apmm-25/trator_gps/ESP32_PWR_Computation_hardware/default_esp32_board/board_step/default_esp32_board.step

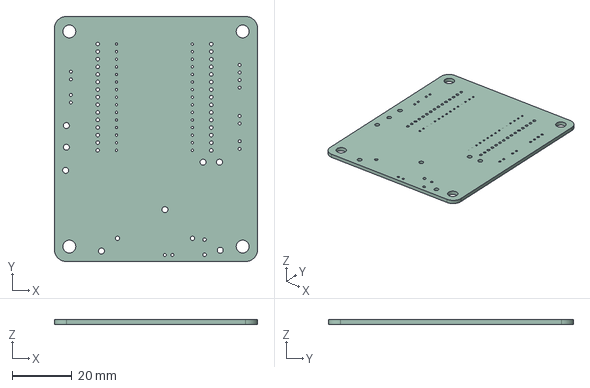
[picture p1: CAD file, 2026-06-18, last stored version]
ESP32_PWR_Computation_hardware/default_esp32_board/board_step/default_esp32_board.step
68.0 x 82.0 x 1.51 mm
