apmm-25/trator_gps/ESP32_PWR_Computation_hardware/default_esp32_board/componentes_zips/LIB_AP63203WU-7/AP63203WU-7/3D/AP63203WU-7.stp

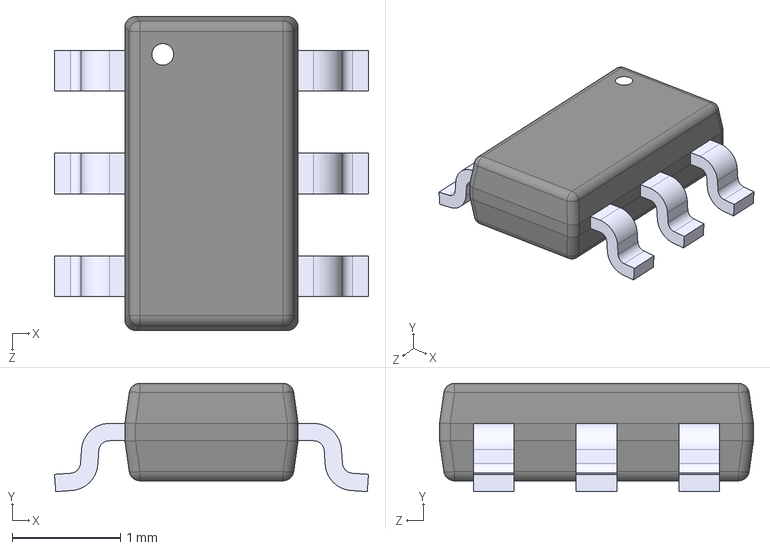
[picture p2: CAD file, 2026-06-18, last stored version]
ESP32_PWR_Computation_hardware/default_esp32_board/componentes_zips/LIB_AP63203WU-7/AP63203WU-7/3D/AP63203WU-7.stp
2.90 x 1.00 x 2.90 mm
