apmm-25/trator_gps/ESP32_PWR_Computation_hardware/default_esp32_board/componentes_zips/LIB_TPS56339DDCR/TPS56339DDCR/3D/TPS56339DDCR.stp

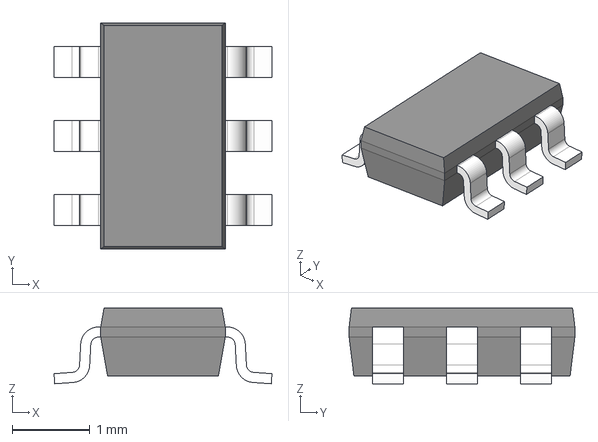
[picture p3: CAD file, 2026-06-18, last stored version]
ESP32_PWR_Computation_hardware/default_esp32_board/componentes_zips/LIB_TPS56339DDCR/TPS56339DDCR/3D/TPS56339DDCR.stp
2.80 x 2.90 x 0.97 mm
BODY-SOT
LEAD-SOT x 6
