apmm-25/trator_gps/(list of files, cad)

Other CAD files:
ESP32_PWR_Computation_hardware/default_esp32_board/componentes_zips/LIB_AP63203WU-7/AP63203WU-7/Allegro/ap63203wu7.psm
ESP32_PWR_Computation_hardware/default_esp32_board/componentes_zips/LIB_AP63203WU-7/AP63203WU-7/DEHDL/ap63203wu_7/chips/chips.prt
ESP32_PWR_Computation_hardware/default_esp32_board/componentes_zips/LIB_TPS56339DDCR/TPS56339DDCR/Allegro/sot95p280x110-6n.psm
ESP32_PWR_Computation_hardware/default_esp32_board/componentes_zips/LIB_TPS56339DDCR/TPS56339DDCR/DEHDL/tps56339ddcr/chips/chips.prt
