apmm-25/trator_gps/(list of files, drawings)

Other design files:
ESP32_PWR_Computation_hardware/default_esp32_board/componentes_zips/LIB_AP63203WU-7/AP63203WU-7/Altium/AP63203WU7.PcbLib
ESP32_PWR_Computation_hardware/default_esp32_board/componentes_zips/LIB_AP63203WU-7/AP63203WU-7/Altium/AP63203WU-7.SchLib
ESP32_PWR_Computation_hardware/default_esp32_board/componentes_zips/LIB_TPS56339DDCR/TPS56339DDCR/Altium/SOT95P280X110-6N.PcbLib
ESP32_PWR_Computation_hardware/default_esp32_board/componentes_zips/LIB_TPS56339DDCR/TPS56339DDCR/Altium/TPS56339DDCR.SchLib
