apmm-25/trator_gps/ESP32_PWR_Computation_hardware/default_esp32_board/default_esp32_board.kicad_pcb

## KiCad design ESP32_PWR_Computation_hardware/default_esp32_board/default_esp32_board.kicad_pcb (2026-06-18, last stored version)

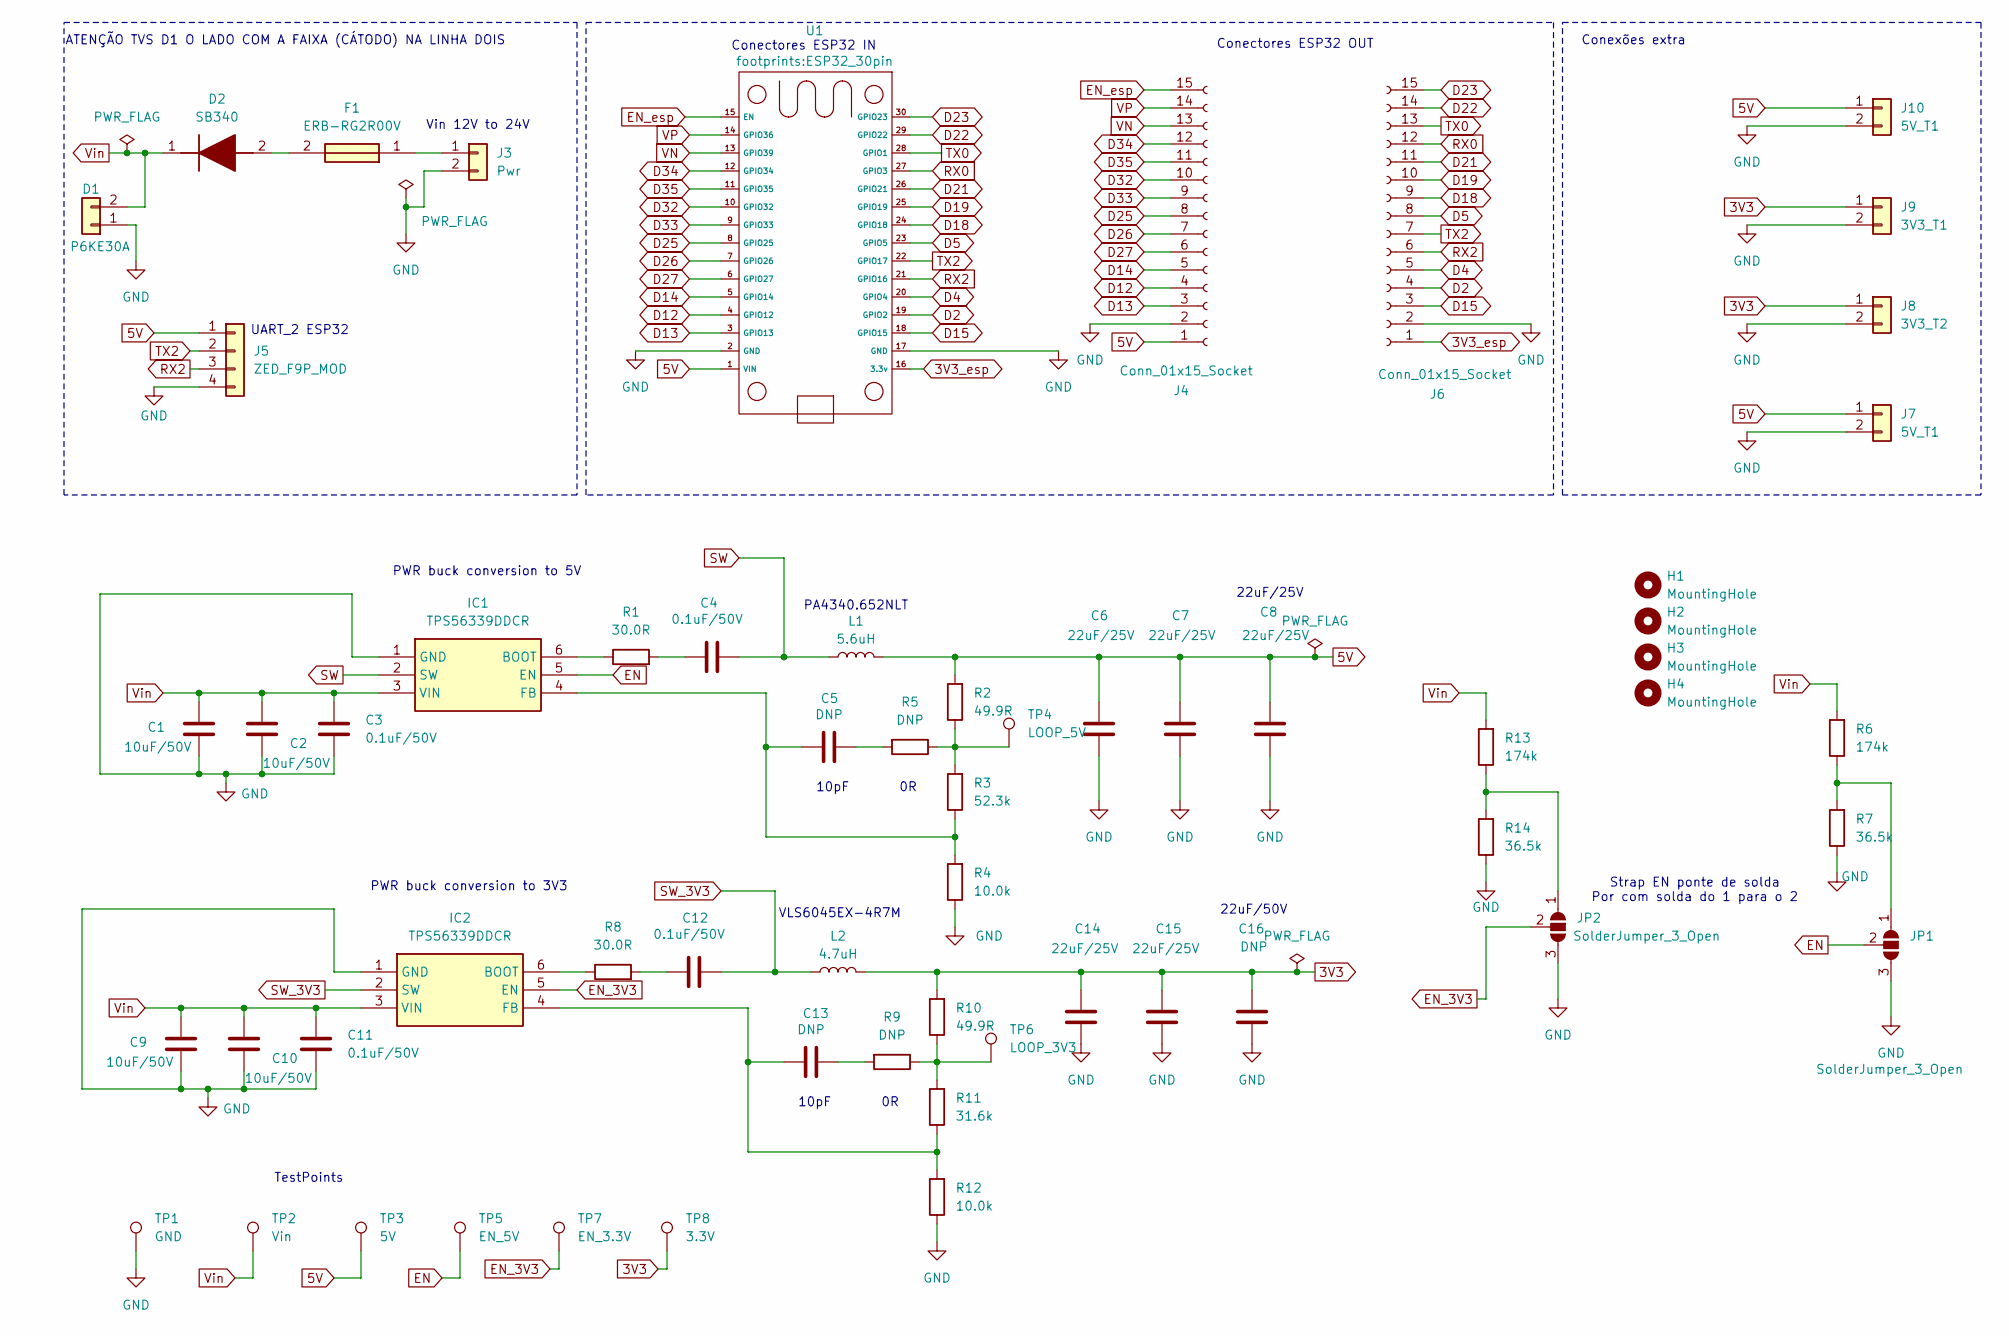
[picture p4: schematic default_esp32_board.kicad_sch]

Parts:
C1, C2, C9, C10: 10uF/50V; C_0805_2012Metric_Pad1.18x1.45mm_HandSolder
C3, C4, C11, C12: 0.1uF/50V; C_0805_2012Metric_Pad1.18x1.45mm_HandSolder
C5, C13, C16: DNP; C_0805_2012Metric_Pad1.18x1.45mm_HandSolder
C6, C7, C8, C14, C15: 22uF/25V; C_0805_2012Metric_Pad1.18x1.45mm_HandSolder
D1: P6KE30A; D_DO-15_P5.08mm_Vertical_KathodeUp
D2: SB340; Mouser Part Number 637-SB340
F1: ERB-RG2R00V; ERBRG4R00V; Mouser Part Number 667-ERB-RG2R00V
H1, H2, H3, H4: MountingHole; MountingHole_4.3mm_M4
IC1, IC2: TPS56339DDCR; Mouser Part Number 595-TPS56339DDCR
J3: Pwr; PinHeader_1x02_P2.54mm_Vertical
J4, J6: Conn_01x15_Socket; M20-7821546
J5: ZED_F9P_MOD; PinHeader_1x04_P2.54mm_Vertical
J7, J10: 5V_T1; PinHeader_1x02_P2.54mm_Vertical
J8: 3V3_T2; PinHeader_1x02_P2.54mm_Vertical
J9: 3V3_T1; PinHeader_1x02_P2.54mm_Vertical
JP1, JP2: SolderJumper_3_Open; SolderJumper-3_P1.3mm_Open_Pad1.0x1.5mm_NumberLabels
L1: 5.6uH; PA4340562NLT
L2: 4.7uH; VLS6045
R1, R8: 30.0R; R_0805_2012Metric_Pad1.20x1.40mm_HandSolder
R2, R10: 49.9R; R_0805_2012Metric_Pad1.20x1.40mm_HandSolder
R3: 52.3k; R_0805_2012Metric_Pad1.20x1.40mm_HandSolder
R4, R12: 10.0k; R_0805_2012Metric_Pad1.20x1.40mm_HandSolder
R5, R9: DNP; R_0805_2012Metric_Pad1.20x1.40mm_HandSolder
R6, R13: 174k; R_0805_2012Metric_Pad1.20x1.40mm_HandSolder
R7, R14: 36.5k; R_0805_2012Metric_Pad1.20x1.40mm_HandSolder
R11: 31.6k; R_0805_2012Metric_Pad1.20x1.40mm_HandSolder
TP1: GND; TestPoint_Plated_Hole_D2.0mm
TP2: Vin; TestPoint_Plated_Hole_D2.0mm
TP3: 5V; TestPoint_Plated_Hole_D2.0mm
TP4: LOOP_5V; TestPoint_Plated_Hole_D2.0mm
TP5: EN_5V; TestPoint_Plated_Hole_D2.0mm
TP6: LOOP_3V3; TestPoint_Plated_Hole_D2.0mm
TP7: EN_3.3V; TestPoint_Plated_Hole_D2.0mm
TP8: 3.3V; TestPoint_Plated_Hole_D2.0mm
U1: ESP32_30pin

Connections:
3V3: C14.1, C15.1, C16.1, J8.1, J9.1, L2.2, R10.2, TP8.1
3V3_esp: J6.1, U1.16 (3.3v)
5V: C6.1, C7.1, C8.1, J4.1, J5.1, J7.1, J10.1, L1.2, R2.2, TP3.1, U1.1 (VIN)
D2: J6.4, U1.19 (GPIO2)
D4: J6.5, U1.20 (GPIO4)
D5: J6.8, U1.23 (GPIO5)
D12: J4.4, U1.4 (GPIO12)
D13: J4.3, U1.3 (GPIO13)
D14: J4.5, U1.5 (GPIO14)
D15: J6.3, U1.18 (GPIO15)
D18: J6.9, U1.24 (GPIO18)
D19: J6.10, U1.25 (GPIO19)
D21: J6.11, U1.26 (GPIO21)
D22: J6.14, U1.29 (GPIO22)
D23: J6.15, U1.30 (GPIO23)
D25: J4.8, U1.8 (GPIO25)
D26: J4.7, U1.7 (GPIO26)
D27: J4.6, U1.6 (GPIO27)
D32: J4.10, U1.10 (GPIO32)
D33: J4.9, U1.9 (GPIO33)
D34: J4.12, U1.12 (GPIO34)
D35: J4.11, U1.11 (GPIO35)
EN: IC1.5 (EN), JP1.2 (C), TP5.1
EN_3V3: IC2.5 (EN), JP2.2 (C), TP7.1
EN_esp: J4.15, U1.15 (EN)
GND: C1.2, C2.2, C3.2, C6.2, C7.2, C8.2, C9.2, C10.2, C11.2, C14.2, C15.2, C16.2, D1.1, IC1.1 (GND), IC2.1 (GND), J3.2, J4.2, J5.4, J6.2, J7.2, J8.2, J9.2, J10.2, JP1.3 (B), JP2.3 (B), R4.1, R7.1, R12.1, R14.1, TP1.1, U1.2 (GND), U1.17 (GND)
unnamed: C4.1, R1.2
unnamed: C5.2, R5.2
unnamed: C12.1, R8.2
unnamed: C13.2, R9.2
unnamed: D2.2 (A), F1.2
unnamed: IC1.6 (BOOT), R1.1
unnamed: C5.1, IC1.4 (FB), R3.1, R4.2
unnamed: IC2.6 (BOOT), R8.1
unnamed: C13.1, IC2.4 (FB), R11.1, R12.2
unnamed: F1.1, J3.1
unnamed: JP1.1 (A), R6.1, R7.2
unnamed: JP2.1 (A), R13.1, R14.2
unnamed: R2.1, R3.2, R5.1, TP4.1
unnamed: R9.1, R10.1, R11.2, TP6.1
RX0: J6.12, U1.27 (GPIO3)
RX2: J5.3, J6.6, U1.21 (GPIO16)
SW: C4.2, IC1.2 (SW), L1.1
SW_3V3: C12.2, IC2.2 (SW), L2.1
TX0: J6.13, U1.28 (GPIO1)
TX2: J5.2, J6.7, U1.22 (GPIO17)
VN: J4.13, U1.13 (GPIO39)
VP: J4.14, U1.14 (GPIO36)
Vin: C1.1, C2.1, C3.1, C9.1, C10.1, C11.1, D1.2, D2.1 (K), IC1.3 (VIN), IC2.3 (VIN), R6.2, R13.2, TP2.1

Notes on the sheet:
Vin 12V to 24V
TestPoints
10pF
PA4340.652NLT
Strap EN ponte de solda Por com solda do 1 para o 2
PWR buck conversion to 5V
Conexões extra
PWR buck conversion to 3V3
Conectores ESP32 IN
22uF/50V
UART_2 ESP32
Conectores ESP32 OUT
VLS6045EX-4R7M
ATENÇÃO TVS D1 O LADO COM A FAIXA (CÁTODO) NA LINHA DOIS
22uF/25V

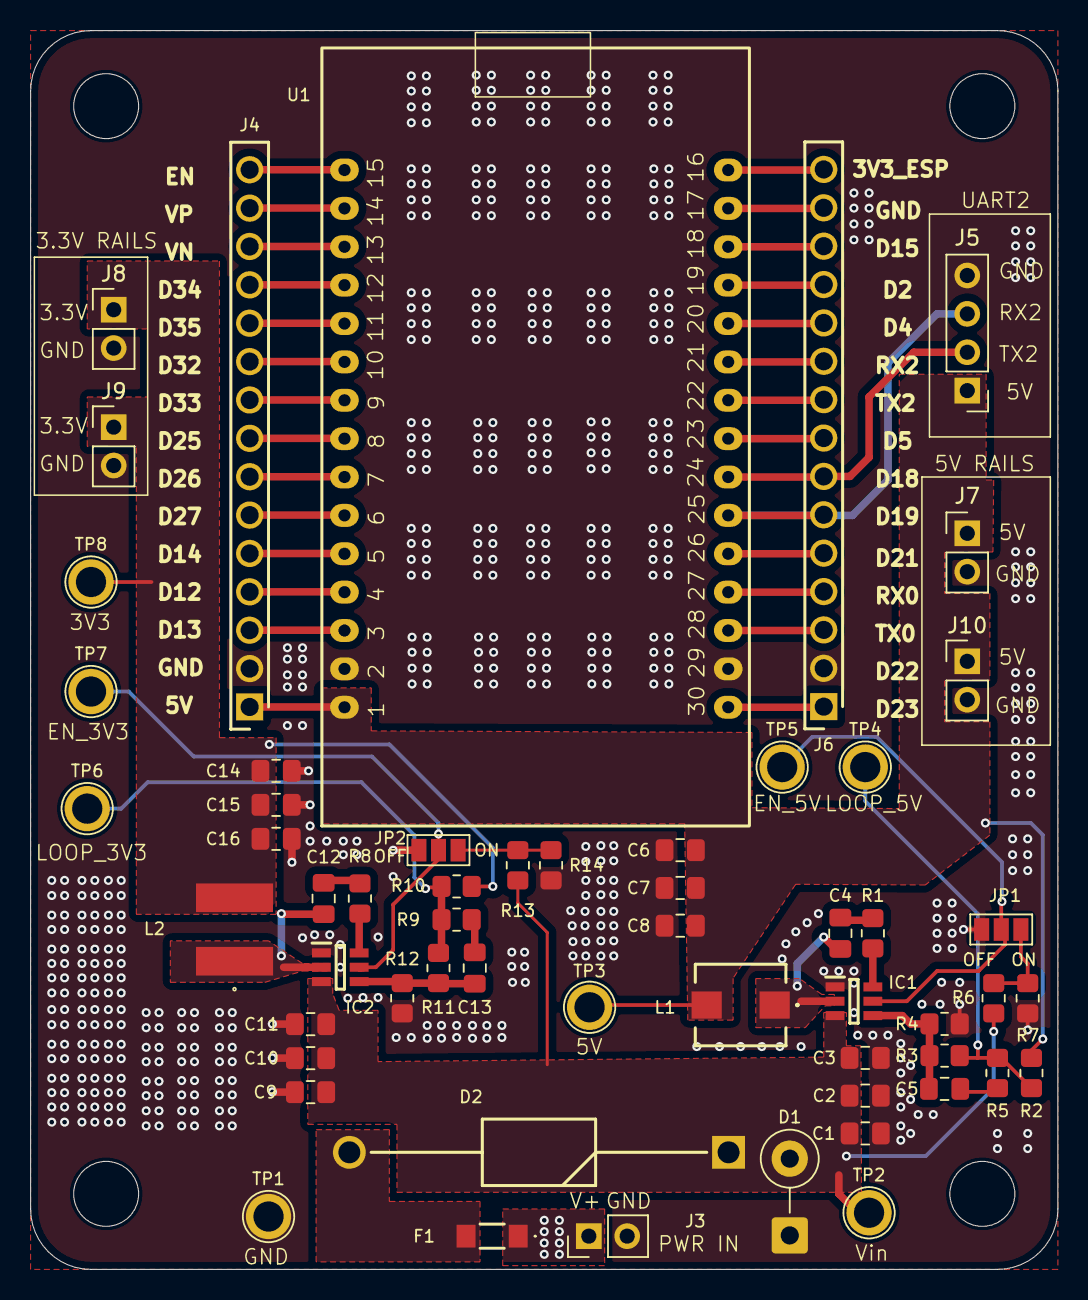
[picture p5: board default_esp32_board.kicad_pcb from above]

Board: 2 copper layers, 68.0 x 82.0 mm, 60 parts (0 on the bottom side), 49 nets.
