apmm-25/trator_gps/ESP32_firmware/trator_gps_firmware/main/components/controller/state_machine.h

/* 
    Author: António Malato
    This is a header file for the state_machine implementation file

    If a change is made add the day and the title of the change here:

    24/6/2026 - Initial creation of the file

*/

#ifndef  STATE_MACHINE_H
#define  STATE_MACHINE_H

#include "common.h"

void state_machine_loop(
    
    uint64_t* num_plantings,
    state_machine_data_t *next_states, 
    sys_data_t sys_data, 
    gps_tracker_t *gps_tracker);

void set_led_planting_mode(bool on);


#endif /* STATE_MACHINE_H */
