apmm-25/trator_gps/(commit log)

2026-06-18 Commiting the KiCad project
    [AP63203WU-7.SchLib, AP63203WU-7.stp, AP63203WU7.PcbLib, EDI2CAP.CFG, SOT95P280X110-6N.PcbLib, TPS56339DDCR.SchLib, TPS56339DDCR.stp, ap63203wu7.psm]
2026-06-18 Separated hardware and firmware into two different repositories.
    [AP63203WU-7.SchLib, AP63203WU-7.stp, AP63203WU7.PcbLib, EDI2CAP.CFG, SOT95P280X110-6N.PcbLib, TPS56339DDCR.SchLib, TPS56339DDCR.stp, ap63203wu7.psm]
2026-06-19 Creating general libraries to send data via uart, i2c or spi, simple abstract function
2026-06-26 implemented WAIT_FOR_PLANT case in the state machine substate
2026-06-29 Implemented parsing for GNS type NMEA messages, and all the functions needed to create that functionality, implemented localization task logic according to the gps data flow
2026-07-01 small fix, forgot to delete unused function
    [gps.c]
2026-07-10 Solved added initializations, solved data transmition to interface bug, ready for real aplication testing
    [common.h, dat.h, gps.c, gps.h, main.c, state_machine.c, state_machine.h]
2026-07-15 Fixed reset bug on the web interface, refactored and divided the state machine loop into diferent functions for better readability
    [common.h, dat.h, gps.c, gps.h, main.c, state_machine.c]
2026-07-30 Implemented GPS Fix type information
    [dat.h, gps.c, types.h]
2026-08-05 Changed the ACTIVATE_PLANTING GPIO after testing the new board
2026-08-18 New read me with current state of the system
